JovanNikolov/VRobotThesis/Documentation/3D parts/sg90 connectors/SG90 Series Universal Holder Arm Version - 6427017/images/c4af265a-7bf6-4ebd-9f52-38b17674a89d.jpg

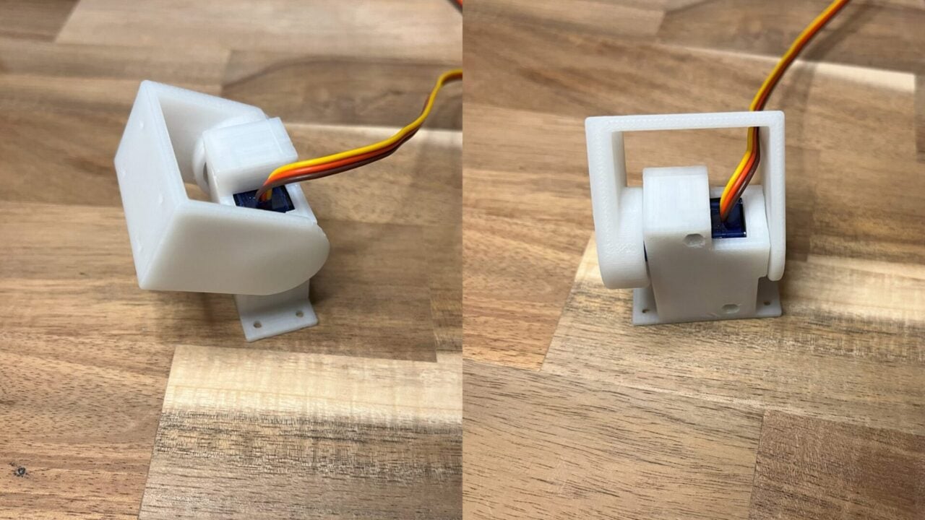
Documentation/3D parts/sg90 connectors/SG90 Series Universal Holder Arm Version - 6427017/images/c4af265a-7bf6-4ebd-9f52-38b17674a89d.jpg
