JovanNikolov/VRobotThesis/Assets/MRTemplateAssets/Sprites/CoachingCards/SpriteSheet.png

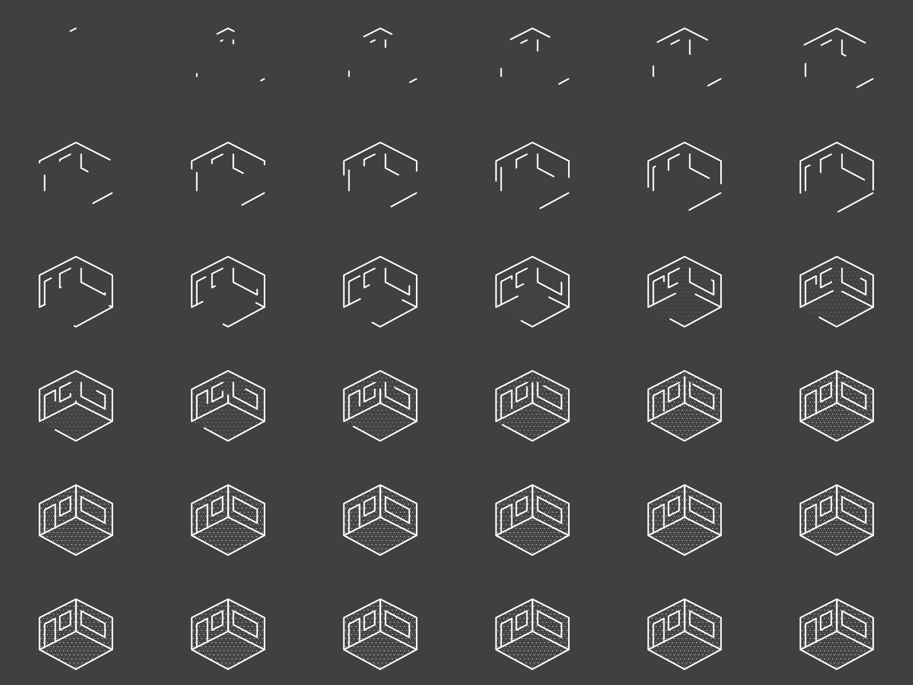
Assets/MRTemplateAssets/Sprites/CoachingCards/SpriteSheet.png
