JovanNikolov/VRobotThesis/Assets/MRTemplateAssets/Sprites/CoachingCards/SpriteSheet_Tap.png

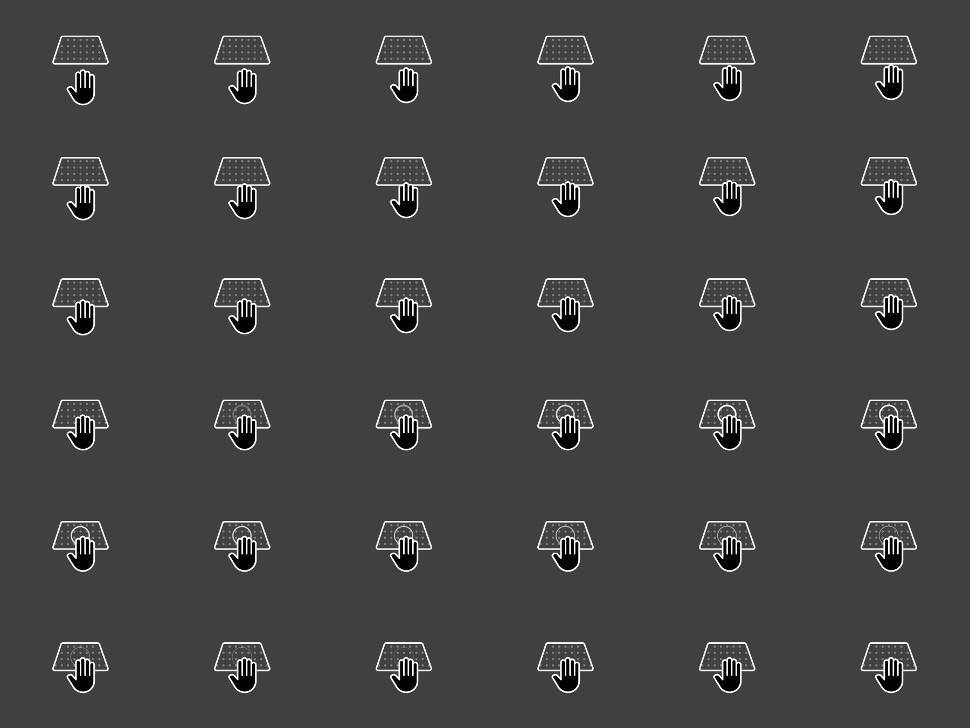
Assets/MRTemplateAssets/Sprites/CoachingCards/SpriteSheet_Tap.png
