JovanNikolov/VRobotThesis/Assets/Plugins/Banana Yellow Games/Characters/Banana Man/Textures/Banana Man Albedo.png

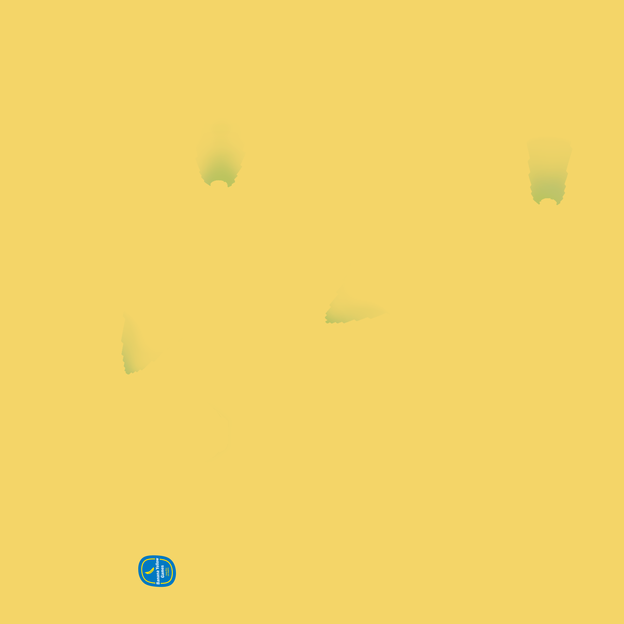
Assets/Plugins/Banana Yellow Games/Characters/Banana Man/Textures/Banana Man Albedo.png
