JovanNikolov/VRobotThesis/Assets/Samples/XR Interaction Toolkit/3.0.7/AR Starter Assets/Textures/PlanePatternDot.png

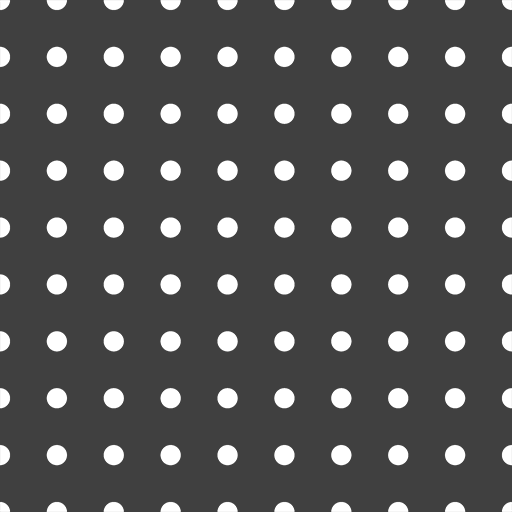
Assets/Samples/XR Interaction Toolkit/3.0.7/AR Starter Assets/Textures/PlanePatternDot.png
