JovanNikolov/VRobotThesis/Assets/Samples/XR Interaction Toolkit/3.0.7/Hands Interaction Demo/Textures/CombinedFingerIndexHighlight.png

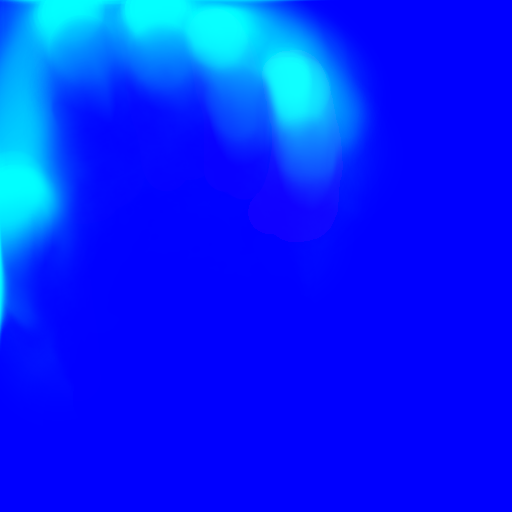
Assets/Samples/XR Interaction Toolkit/3.0.7/Hands Interaction Demo/Textures/CombinedFingerIndexHighlight.png
