JovanNikolov/VRobotThesis/Assets/SteamVR/InteractionSystem/Samples/Grenade/SunFlare.png

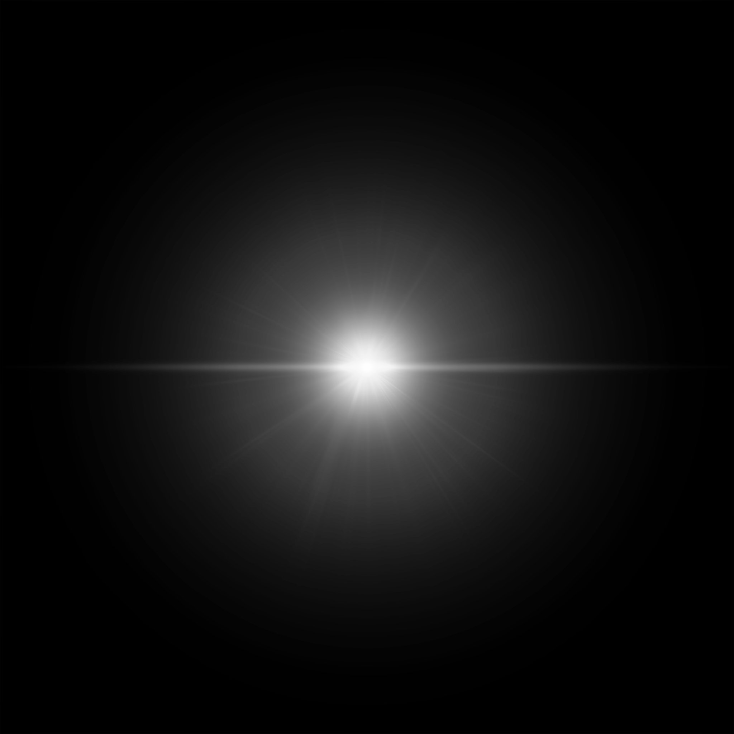
Assets/SteamVR/InteractionSystem/Samples/Grenade/SunFlare.png
