JovanNikolov/VRobotThesis/Documentation/3D parts/Hands/Robot Gripper 9g Micro Servo - 715525/README.txt

Robot Gripper 9g Micro Servo by yisparyan on Thingiverse: https://www.thingiverse.com/thing:715525

Summary:
Designed for use with 4mm bolts and 9g Servo. May have to change the way the servo fits later.
