JovanNikolov/VRobotThesis/Assets/MRTemplateAssets/Materials/Controller/DefaultMaterial_AO.png

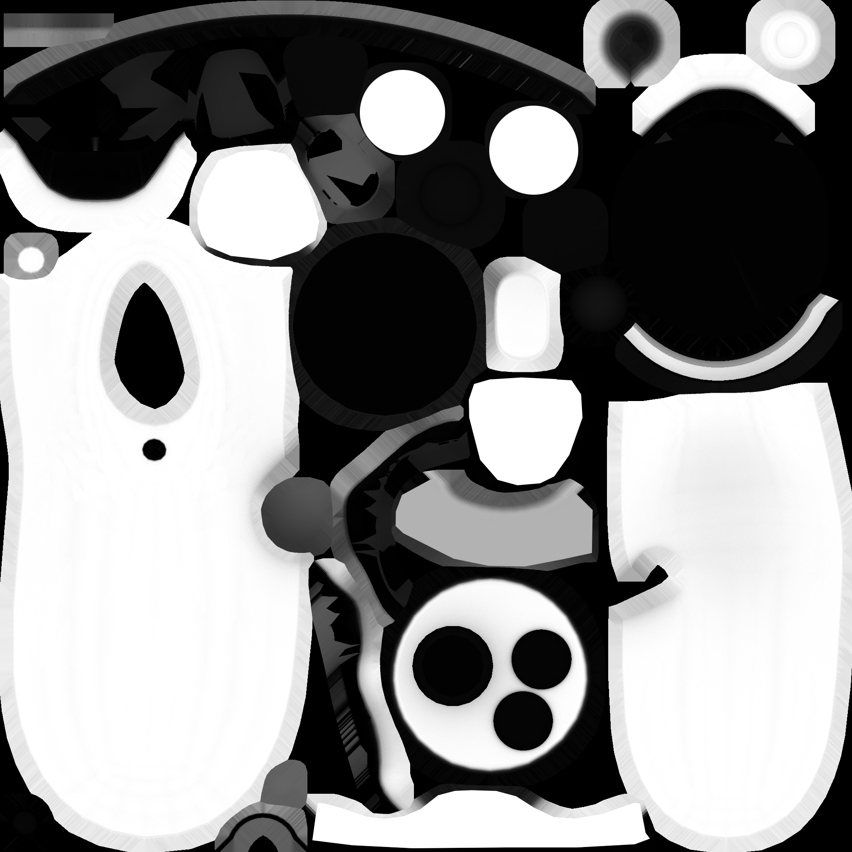
Assets/MRTemplateAssets/Materials/Controller/DefaultMaterial_AO.png
