JovanNikolov/VRobotThesis/Assets/MRTemplateAssets/Materials/Primitive/Torus_BaseColor.png

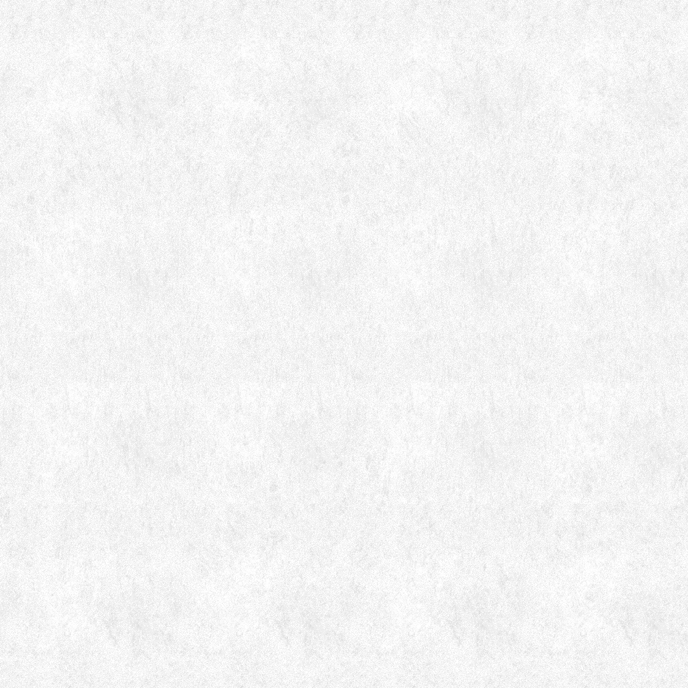
Assets/MRTemplateAssets/Materials/Primitive/Torus_BaseColor.png
