JovanNikolov/VRobotThesis/Documentation/3D parts/Camera/SG90 MG90 Servo Pan and Tilt Camera platform - 6008663/images/9f7ce456-4472-4701-ab53-bb280a71be2b.png

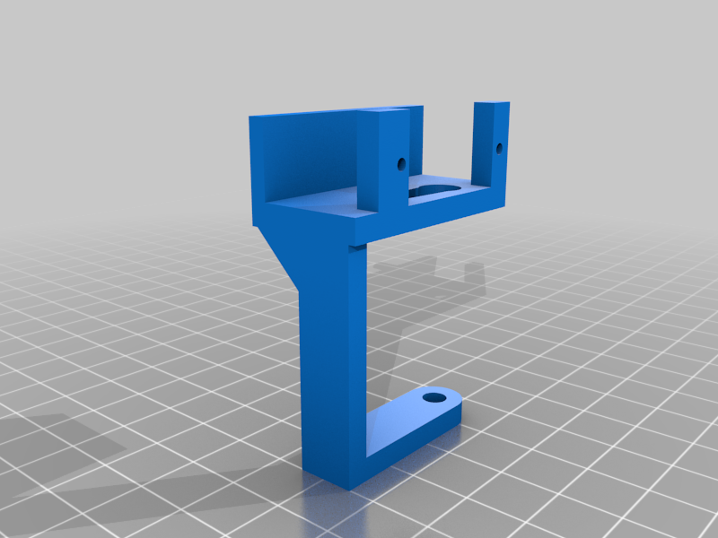
Documentation/3D parts/Camera/SG90 MG90 Servo Pan and Tilt Camera platform - 6008663/images/9f7ce456-4472-4701-ab53-bb280a71be2b.png
