JovanNikolov/VRobotThesis/Documentation/3D parts/Camera/SG90 MG90 Servo Pan and Tilt Camera platform - 6008663/images/9fc777da-9fff-4db4-94f2-86201f8a9296.png

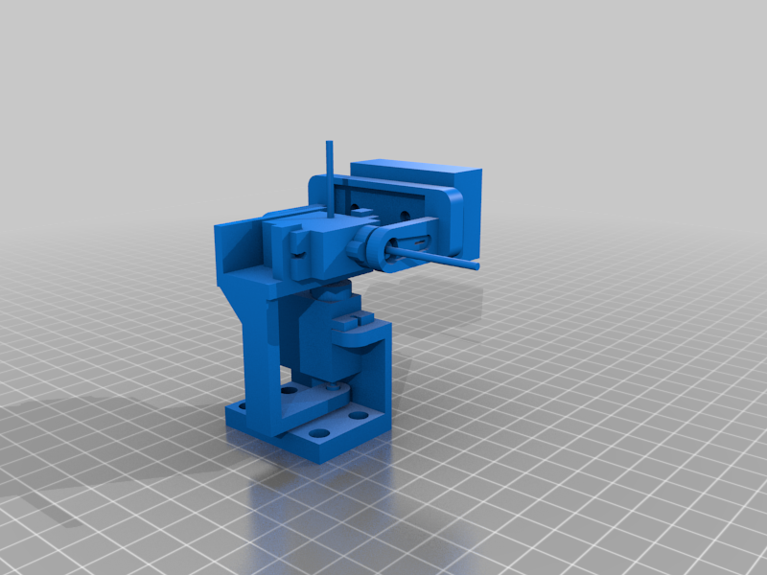
Documentation/3D parts/Camera/SG90 MG90 Servo Pan and Tilt Camera platform - 6008663/images/9fc777da-9fff-4db4-94f2-86201f8a9296.png
