JovanNikolov/VRobotThesis/Documentation/3D parts/Camera/SG90 MG90 Servo Pan and Tilt Camera platform - 6008663/images/04854080-c626-4767-88ed-b8ee575ed862.png

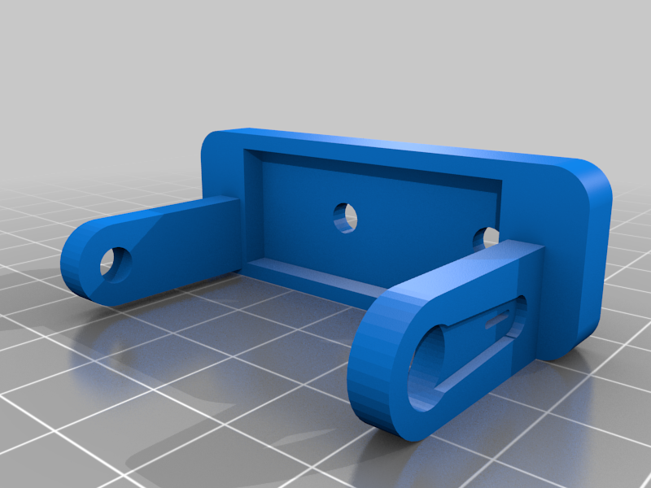
Documentation/3D parts/Camera/SG90 MG90 Servo Pan and Tilt Camera platform - 6008663/images/04854080-c626-4767-88ed-b8ee575ed862.png
