JovanNikolov/VRobotThesis/Documentation/3D parts/Camera/SG90 MG90 Servo Pan and Tilt Camera platform - 6008663/images/7014697e-79d9-4a63-8440-9a916e41d4f0.png

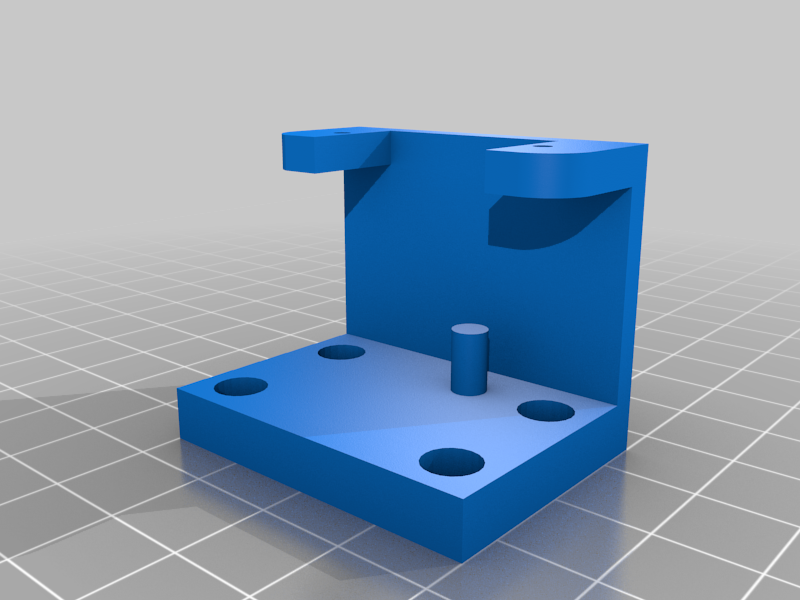
Documentation/3D parts/Camera/SG90 MG90 Servo Pan and Tilt Camera platform - 6008663/images/7014697e-79d9-4a63-8440-9a916e41d4f0.png
