JovanNikolov/VRobotThesis/Documentation/3D parts/Camera/SG90 MG90 Servo Pan and Tilt Camera platform - 6008663/images/df4db00b-a1f9-4d64-a55b-acda108fb439.JPEG

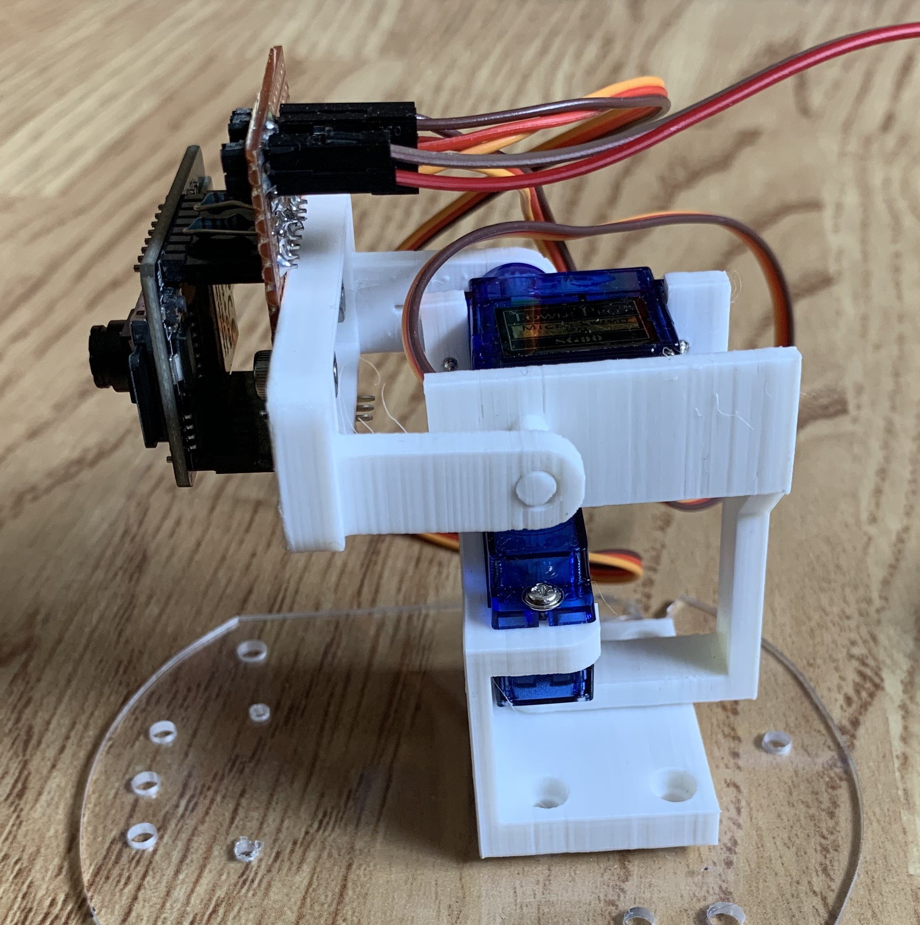
Documentation/3D parts/Camera/SG90 MG90 Servo Pan and Tilt Camera platform - 6008663/images/df4db00b-a1f9-4d64-a55b-acda108fb439.JPEG
