JovanNikolov/VRobotThesis/Documentation/3D parts/Hands/Robot Gripper 9g Micro Servo - 715525/images/Connector.png

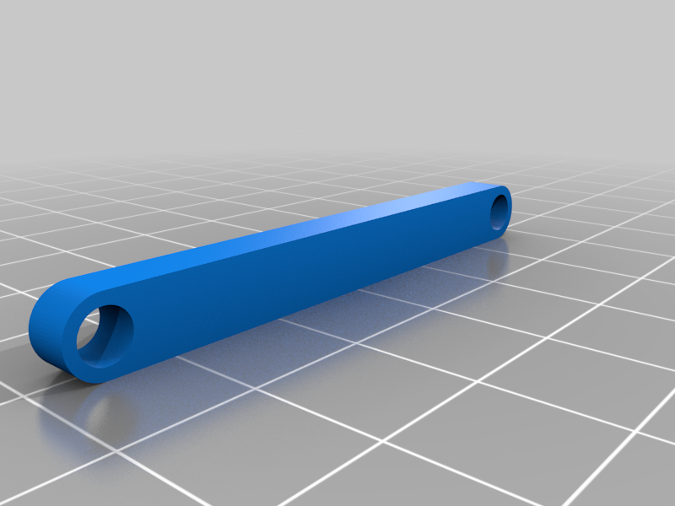
Documentation/3D parts/Hands/Robot Gripper 9g Micro Servo - 715525/images/Connector.png
