JovanNikolov/VRobotThesis/Documentation/3D parts/sg90 connectors/SG90 Series Universal Holder Arm Version - 6427017/images/8ed42bbf-4547-4850-8e12-36082bc721a6.jpg

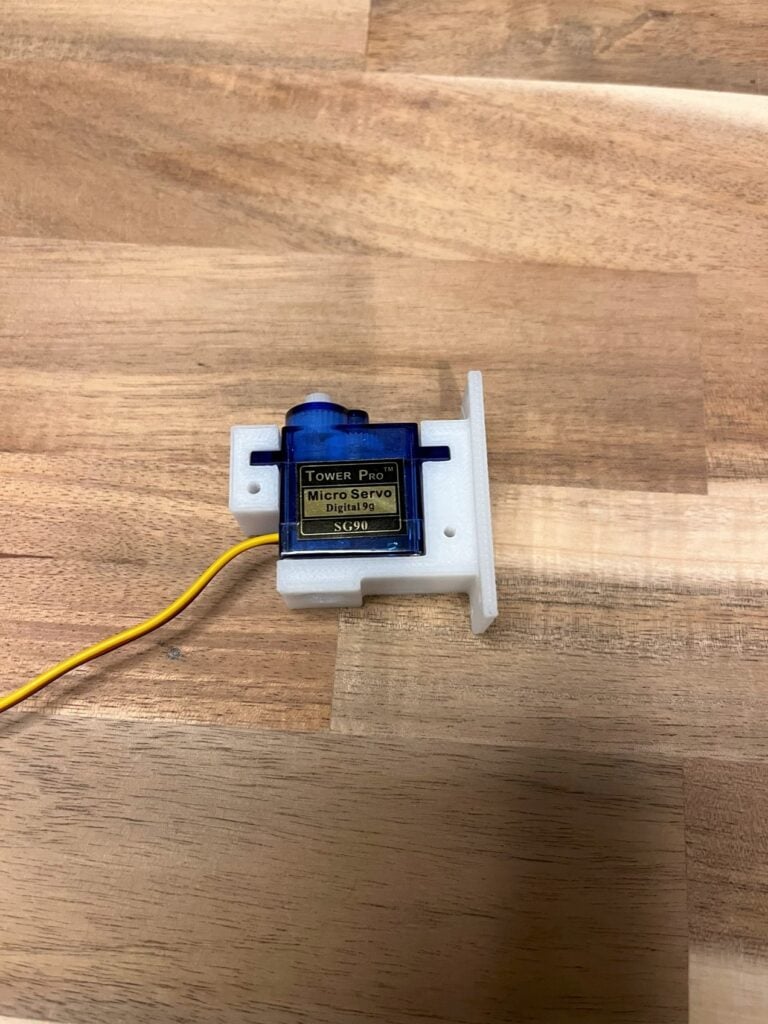
Documentation/3D parts/sg90 connectors/SG90 Series Universal Holder Arm Version - 6427017/images/8ed42bbf-4547-4850-8e12-36082bc721a6.jpg
