JovanNikolov/VRobotThesis/Documentation/3D parts/sg90 connectors/SG90 Series Universal Holder Arm Version - 6427017/images/9cceeb7c-fc35-44a0-94d8-8c8fdba87461.png

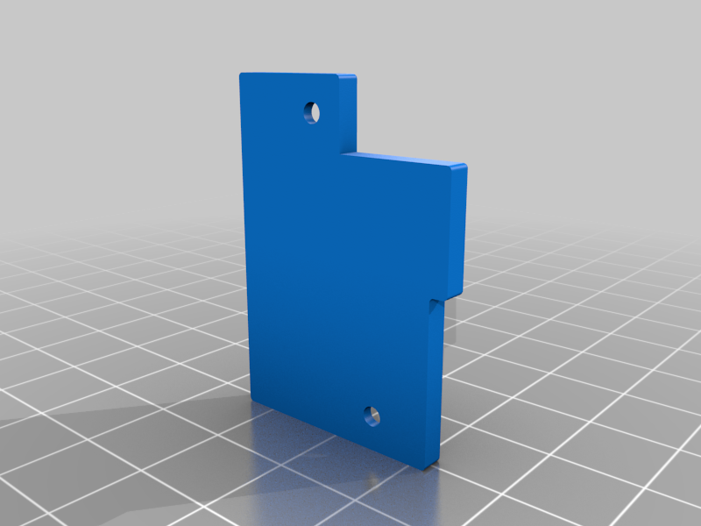
Documentation/3D parts/sg90 connectors/SG90 Series Universal Holder Arm Version - 6427017/images/9cceeb7c-fc35-44a0-94d8-8c8fdba87461.png
