JovanNikolov/VRobotThesis/Documentation/3D parts/sg90 connectors/SG90 Series Universal Holder Arm Version - 6427017/images/975d6252-f911-4170-b1a8-1cbef1e1c409.jpg

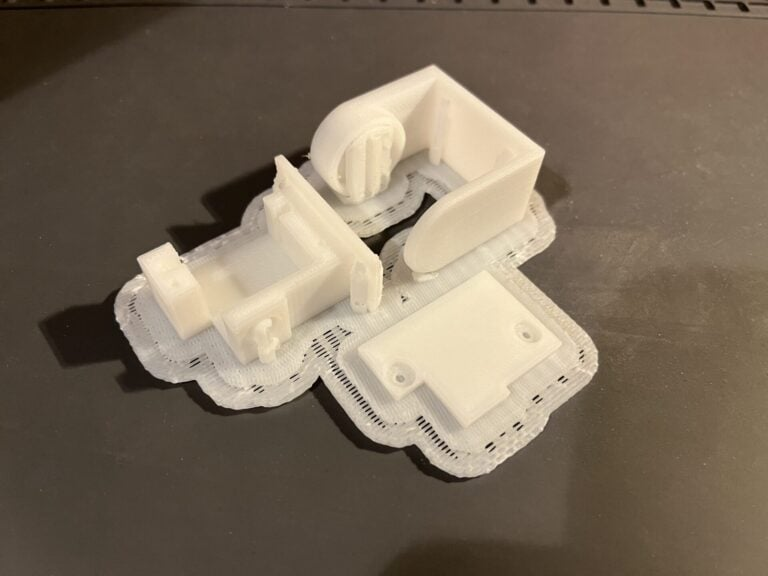
Documentation/3D parts/sg90 connectors/SG90 Series Universal Holder Arm Version - 6427017/images/975d6252-f911-4170-b1a8-1cbef1e1c409.jpg
