JovanNikolov/VRobotThesis/Documentation/3D parts/sg90 connectors/SG90 Series Universal Holder Arm Version - 6427017/images/08483cea-c3a9-4e52-a186-e3168a5c99b9.jpg

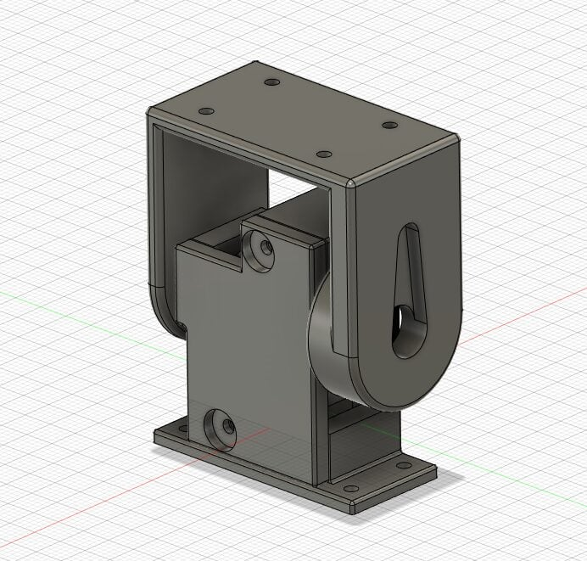
Documentation/3D parts/sg90 connectors/SG90 Series Universal Holder Arm Version - 6427017/images/08483cea-c3a9-4e52-a186-e3168a5c99b9.jpg
