JovanNikolov/VRobotThesis/Documentation/3D parts/sg90 connectors/SG90 Series Universal Holder Arm Version - 6427017/images/96917006-be8b-4bbc-bf6c-dac83df0b48c.png

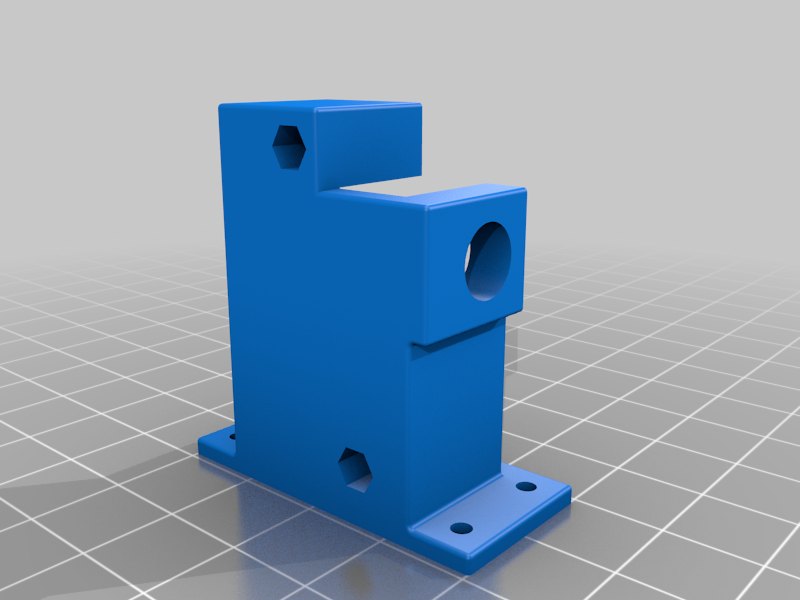
Documentation/3D parts/sg90 connectors/SG90 Series Universal Holder Arm Version - 6427017/images/96917006-be8b-4bbc-bf6c-dac83df0b48c.png
