JovanNikolov/VRobotThesis/Documentation/3D parts/sg90 connectors/SG90 Series Universal Holder Arm Version - 6427017/images/c0e65ba7-dce6-438d-bd89-70d3c0b25c54.png

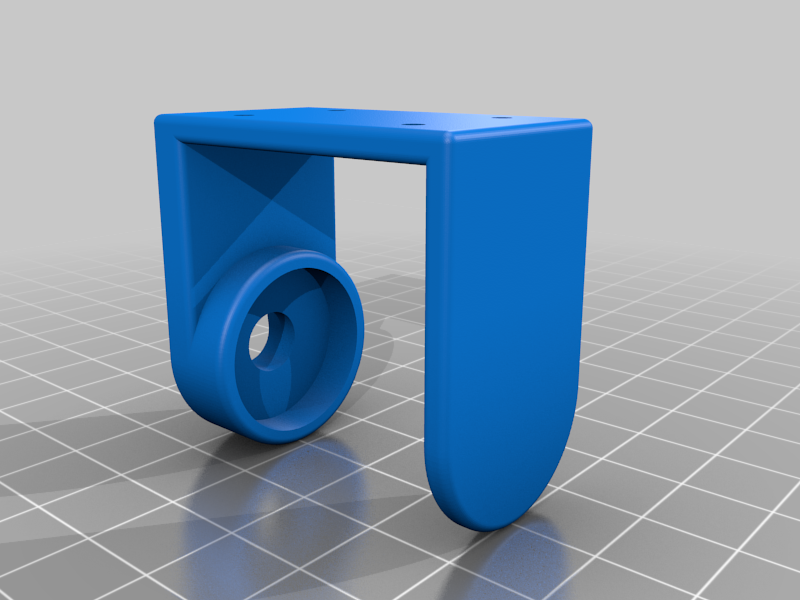
Documentation/3D parts/sg90 connectors/SG90 Series Universal Holder Arm Version - 6427017/images/c0e65ba7-dce6-438d-bd89-70d3c0b25c54.png
