JovanNikolov/VRobotThesis/Documentation/3D parts/Body/Magnificent Densor.stl

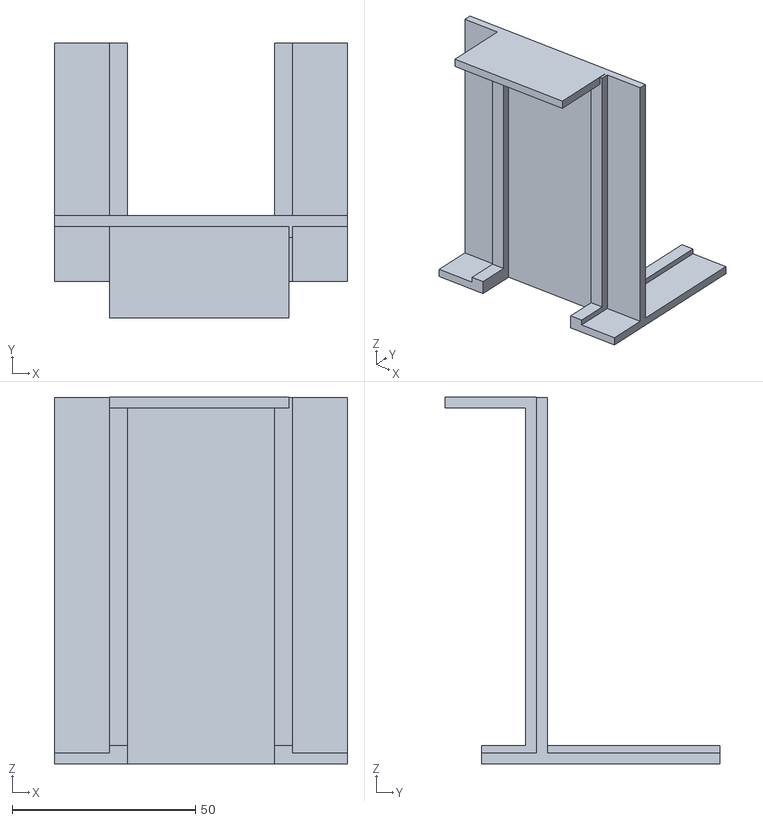
[picture p118: CAD file, 2026-06-03]
Documentation/3D parts/Body/Magnificent Densor.stl
80.0 x 75.0 x 100.1
