JovanNikolov/VRobotThesis/Documentation/3D parts/Camera/SG90 MG90 Servo Pan and Tilt Camera platform - 6008663/files/Shiny_Trug_2.stl

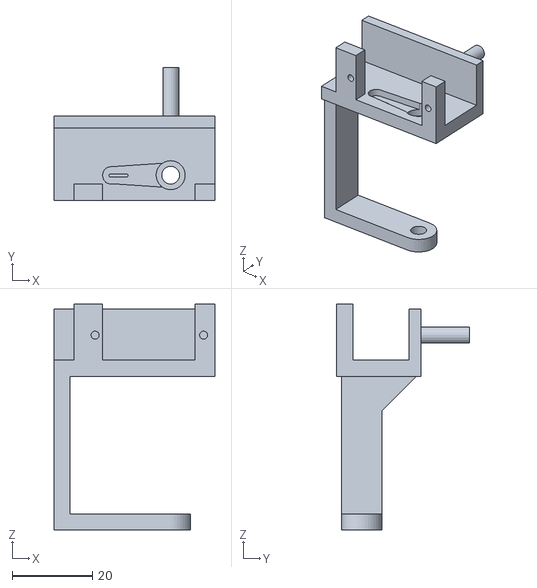
[picture p119: CAD file, 2026-06-03]
Documentation/3D parts/Camera/SG90 MG90 Servo Pan and Tilt Camera platform - 6008663/files/Shiny_Trug_2.stl
40.0 x 33.0 x 56.2
