JovanNikolov/VRobotThesis/Documentation/3D parts/Forearms/Surprising Uusam-Hillar.stl

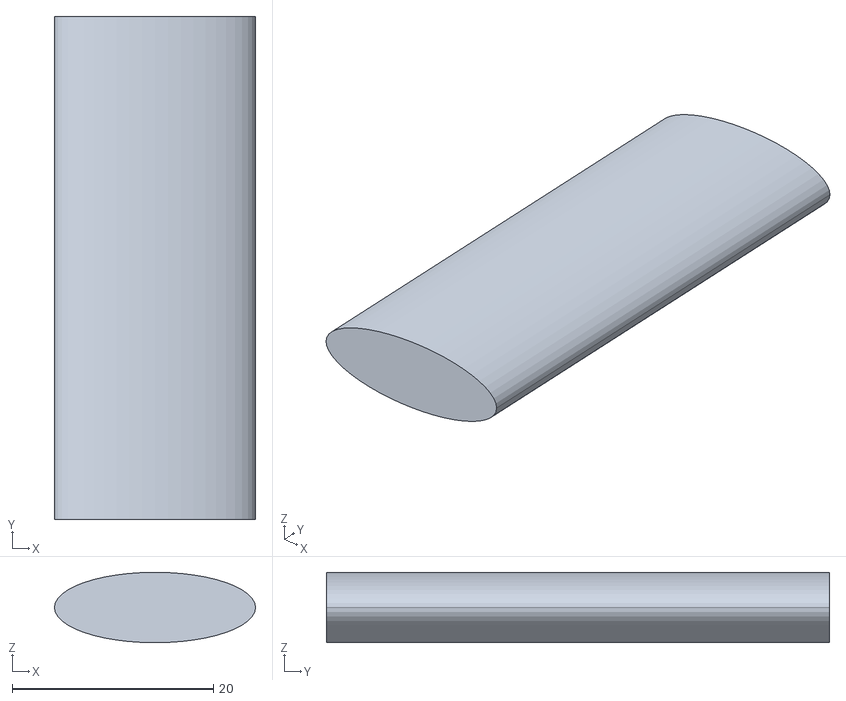
[picture p120: CAD file, 2026-06-03]
Documentation/3D parts/Forearms/Surprising Uusam-Hillar.stl
20.0 x 50.0 x 7.00
