JovanNikolov/VRobotThesis/Documentation/3D parts/Hands/Robot Gripper 9g Micro Servo - 715525/files/Base.stl

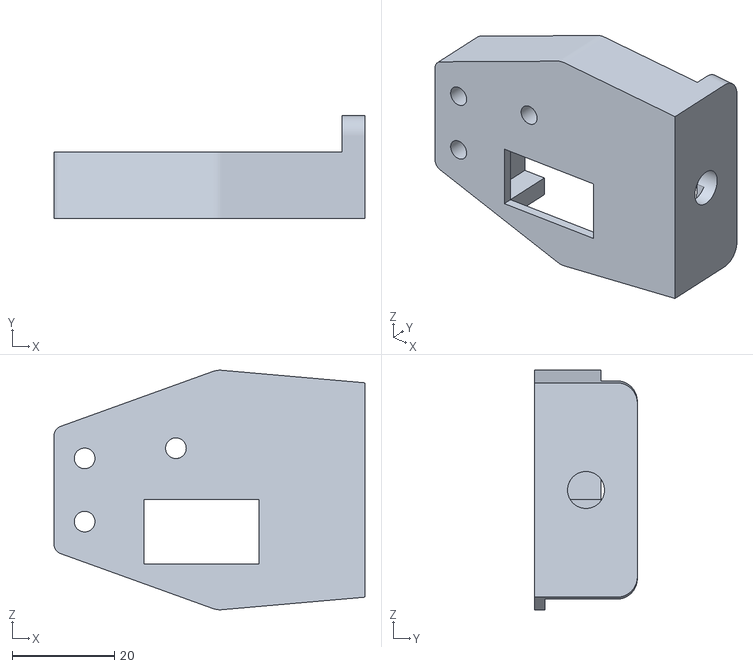
[picture p121: CAD file, 2026-06-03]
Documentation/3D parts/Hands/Robot Gripper 9g Micro Servo - 715525/files/Base.stl
60.9 x 20.1 x 46.9
