JovanNikolov/VRobotThesis/Documentation/3D parts/Hands/Robot Gripper Final/robotHands.stl

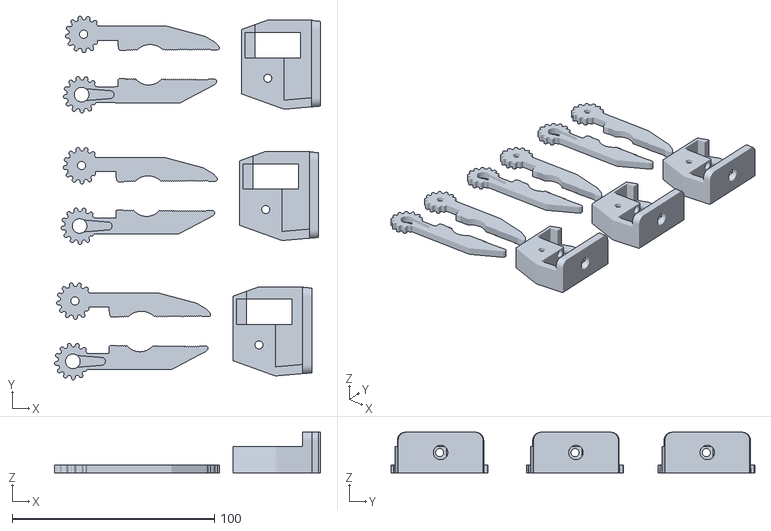
[picture p122: CAD file, 2026-06-03]
Documentation/3D parts/Hands/Robot Gripper Final/robotHands.stl
131.6 x 180.0 x 20.1
