JovanNikolov/VRobotThesis/Documentation/3D parts/MG996R connectors V2/MG996R Servo 3030 Mount.stl

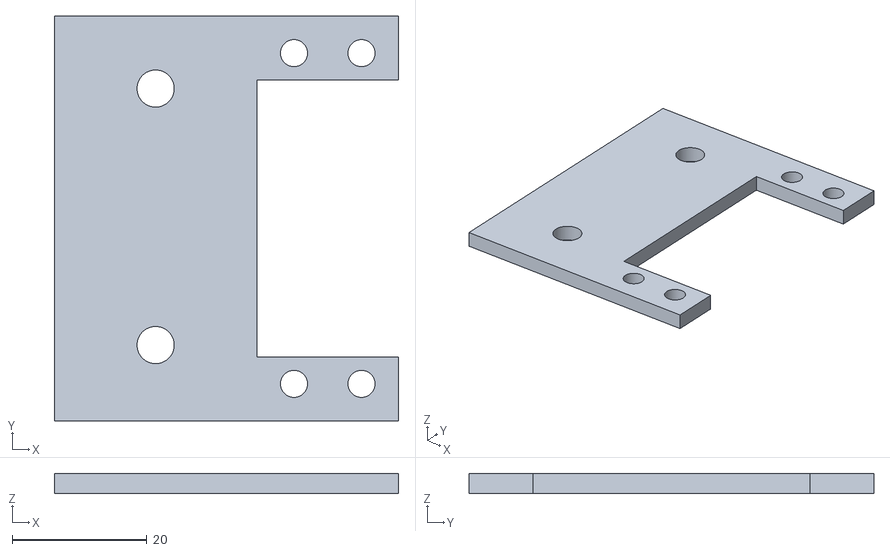
[picture p123: CAD file, 2026-06-03]
Documentation/3D parts/MG996R connectors V2/MG996R Servo 3030 Mount.stl
51.0 x 60.0 x 3.00
