JovanNikolov/VRobotThesis/Documentation/3D parts/MG996R connectors/servoholder04.stl

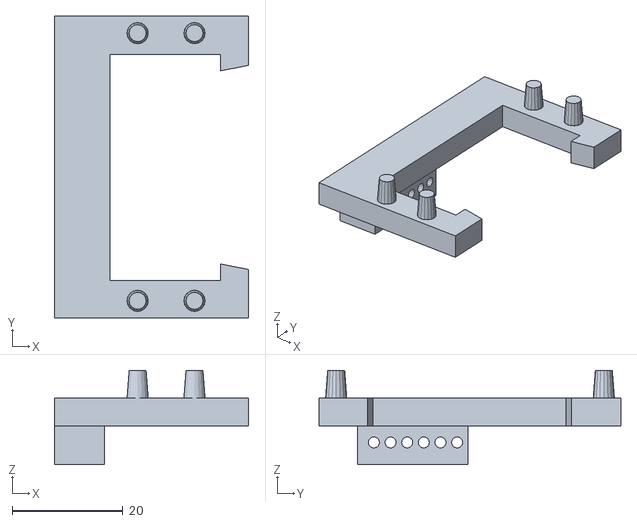
[picture p124: CAD file, 2026-06-03]
Documentation/3D parts/MG996R connectors/servoholder04.stl
35.0 x 54.4 x 17.0
