JovanNikolov/VRobotThesis/Documentation/3D parts/sg90 connectors/SG90 Series Universal Holder Arm Version - 6427017/files/base.stl

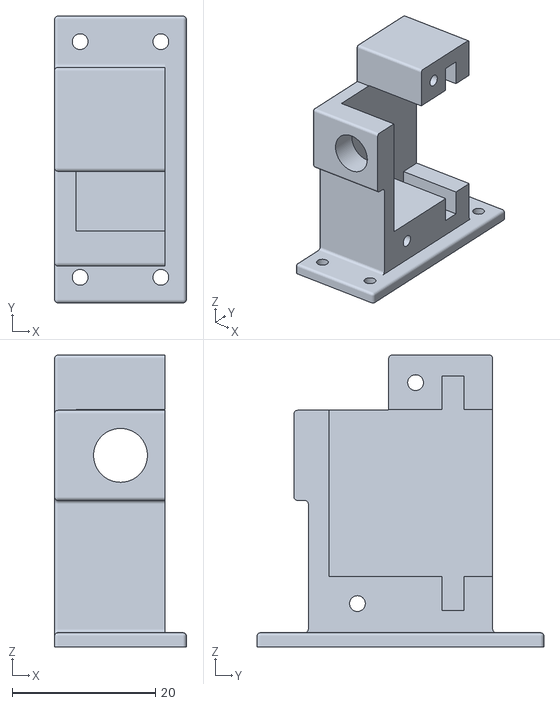
[picture p125: CAD file, 2026-06-03]
Documentation/3D parts/sg90 connectors/SG90 Series Universal Holder Arm Version - 6427017/files/base.stl
18.4 x 40.0 x 40.7
