JovanNikolov/VRobotThesis/Documentation/3D parts/Body/Magnificent Densor Laying.stl

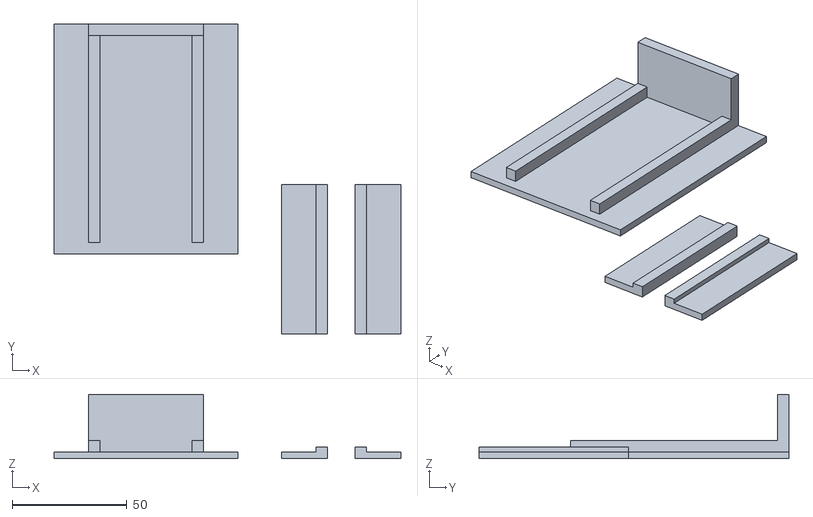
[picture p126: CAD file, 2026-06-03]
Documentation/3D parts/Body/Magnificent Densor Laying.stl
151.0 x 135.0 x 28.0
