JovanNikolov/VRobotThesis/Documentation/3D parts/Camera/SG90 MG90 Servo Pan and Tilt Camera platform - 6008663/files/SG90_MG90_Pan_and_Tilt_2a.stl

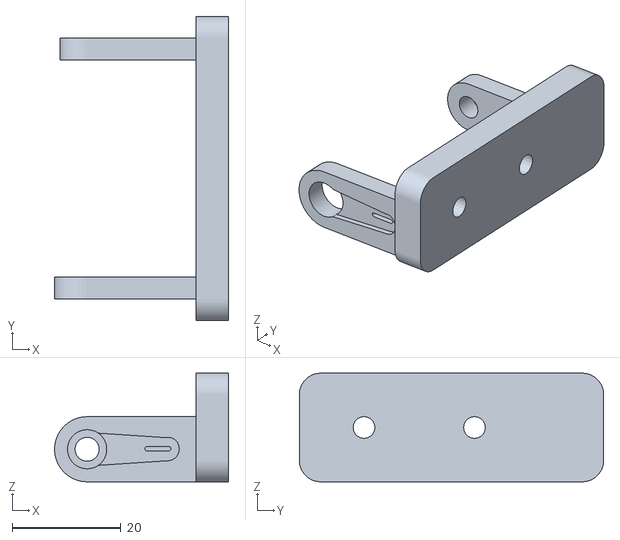
[picture p127: CAD file, 2026-06-03]
Documentation/3D parts/Camera/SG90 MG90 Servo Pan and Tilt Camera platform - 6008663/files/SG90_MG90_Pan_and_Tilt_2a.stl
32.0 x 56.0 x 20.0
