JovanNikolov/VRobotThesis/Documentation/3D parts/Hands/Robot Gripper 9g Micro Servo - 715525/files/Connector_Gear.stl

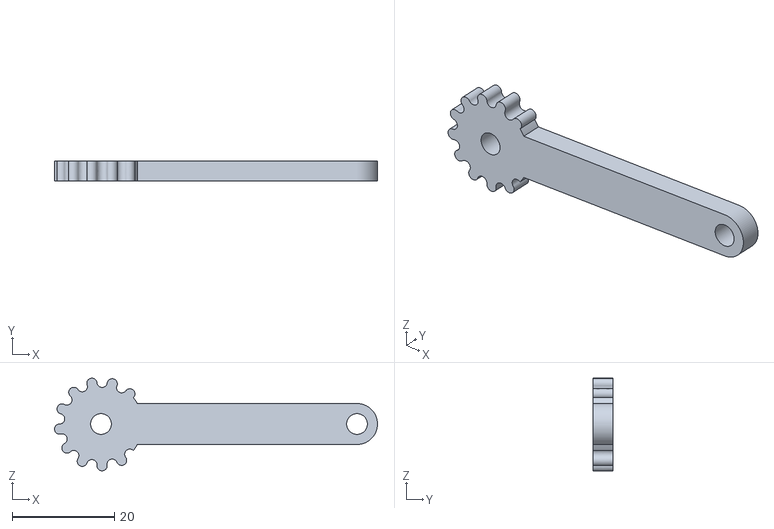
[picture p128: CAD file, 2026-06-03]
Documentation/3D parts/Hands/Robot Gripper 9g Micro Servo - 715525/files/Connector_Gear.stl
63.1 x 4.00 x 18.1
