JovanNikolov/VRobotThesis/Documentation/3D parts/sg90 connectors/SG90 Series Universal Holder Arm Version - 6427017/files/arm.stl

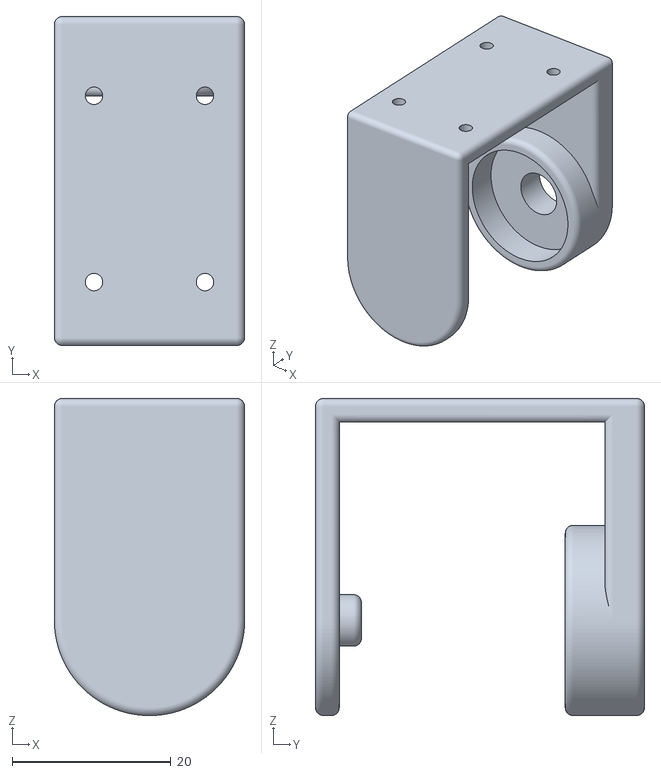
[picture p129: CAD file, 2026-06-03]
Documentation/3D parts/sg90 connectors/SG90 Series Universal Holder Arm Version - 6427017/files/arm.stl
24.0 x 41.5 x 40.0
