JovanNikolov/VRobotThesis/Documentation/3D parts/Camera/SG90 MG90 Servo Pan and Tilt Camera platform - 6008663/files/bQn3oL0MOp6.stl

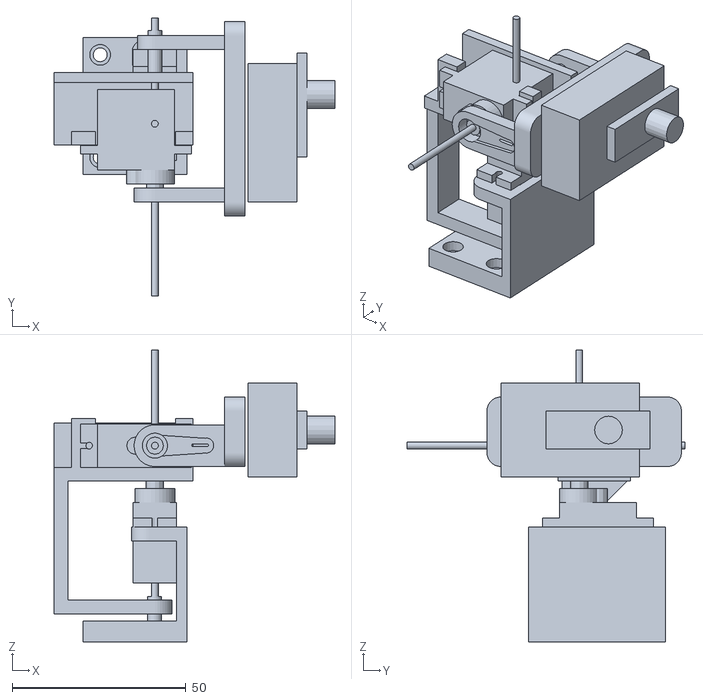
[picture p130: CAD file, 2026-06-03]
Documentation/3D parts/Camera/SG90 MG90 Servo Pan and Tilt Camera platform - 6008663/files/bQn3oL0MOp6.stl
80.9 x 80.0 x 84.0
