JovanNikolov/VRobotThesis/Documentation/3D parts/sg90 connectors/SG90 Series Universal Holder Arm Version - 6427017/files/cover.stl

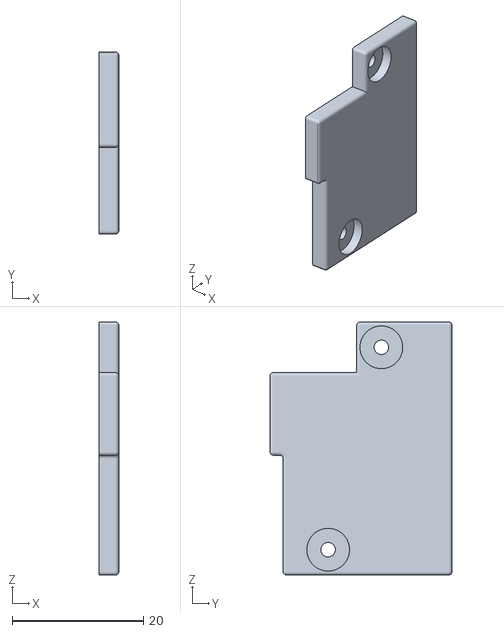
[picture p131: CAD file, 2026-06-03]
Documentation/3D parts/sg90 connectors/SG90 Series Universal Holder Arm Version - 6427017/files/cover.stl
3.00 x 27.7 x 38.5
