JovanNikolov/VRobotThesis/Documentation/3D parts/Camera/SG90 MG90 Servo Pan and Tilt Camera platform - 6008663/files/Shiny_Trug_1.stl

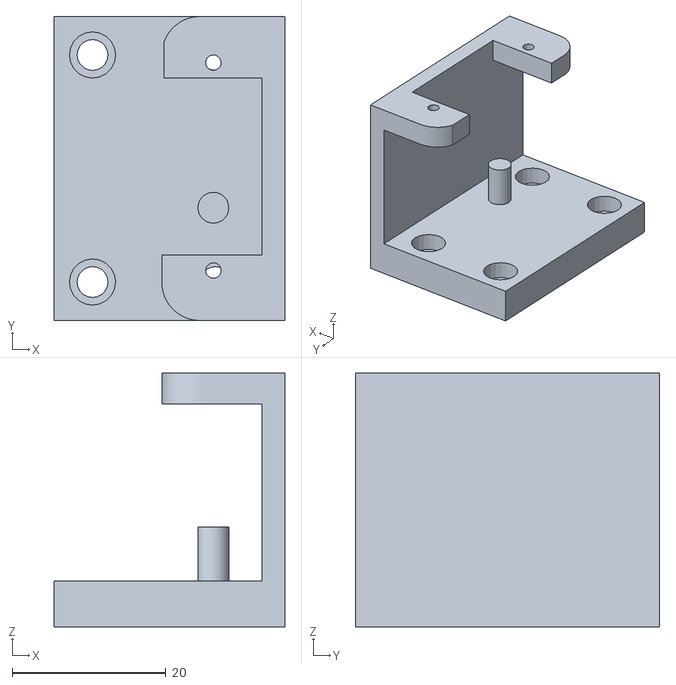
[picture p132: CAD file, 2026-06-03]
Documentation/3D parts/Camera/SG90 MG90 Servo Pan and Tilt Camera platform - 6008663/files/Shiny_Trug_1.stl
30.0 x 39.5 x 33.0
