JovanNikolov/VRobotThesis/Documentation/3D parts/Hands/Robot Gripper 9g Micro Servo - 715525/files/Claw.stl

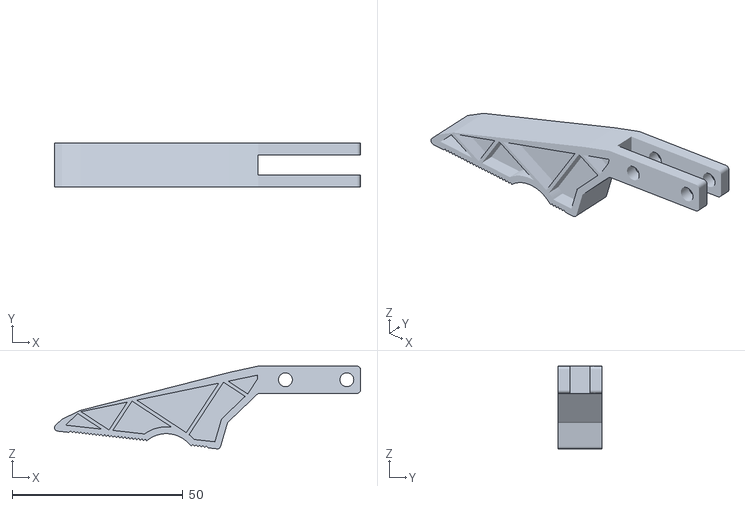
[picture p133: CAD file, 2026-06-03]
Documentation/3D parts/Hands/Robot Gripper 9g Micro Servo - 715525/files/Claw.stl
89.7 x 12.9 x 24.3
