JovanNikolov/VRobotThesis/Documentation/3D parts/Hands/Robot Gripper 9g Micro Servo - 715525/files/Connector.stl

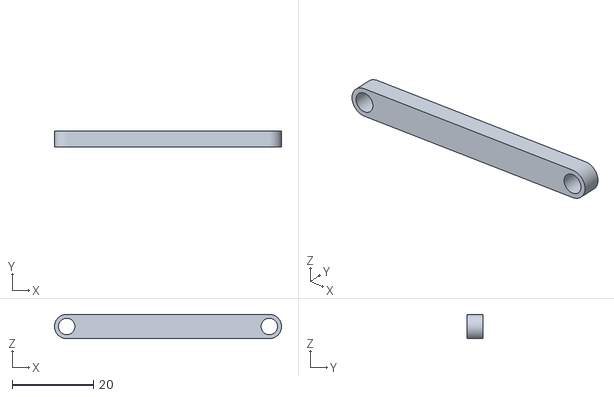
[picture p134: CAD file, 2026-06-03]
Documentation/3D parts/Hands/Robot Gripper 9g Micro Servo - 715525/files/Connector.stl
56.0 x 4.00 x 6.00
