JovanNikolov/VRobotThesis/(list of files, cad)

Other CAD files:
Documentation/3D parts/Spoeni/Camerax2MG996RConnV2x2.stl
Documentation/3D parts/Spoeni/Forearmsx1Handsx1MG996rConx2sg90conx2.stl
Documentation/3D parts/Hands/Robot Gripper 9g Micro Servo - 715525/files/Servo_Connector_Gear.stl
