JovanNikolov/VRobotThesis/Assets/MRTemplateAssets/Sprites/CoachingCards/CoachingStep1.png

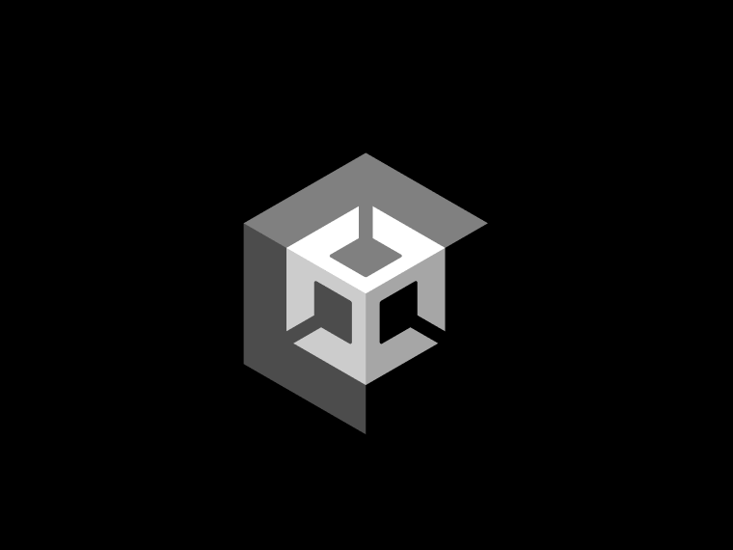
Assets/MRTemplateAssets/Sprites/CoachingCards/CoachingStep1.png
