JovanNikolov/VRobotThesis/Assets/MRTemplateAssets/Tutorial/Images/Project-Header.png

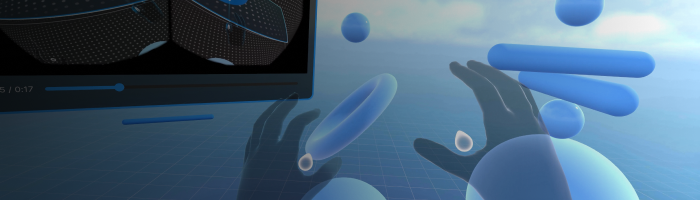
Assets/MRTemplateAssets/Tutorial/Images/Project-Header.png
