JovanNikolov/VRobotThesis/Assets/MRTemplateAssets/Tutorial/Images/Welcome-Screen-Image.png

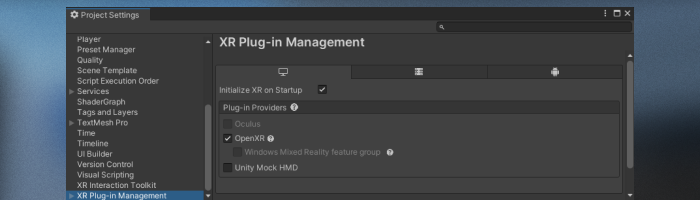
Assets/MRTemplateAssets/Tutorial/Images/Welcome-Screen-Image.png
